olivier-boesch/apico_server/electronics/bees_io/bees_io_pcb_view.png

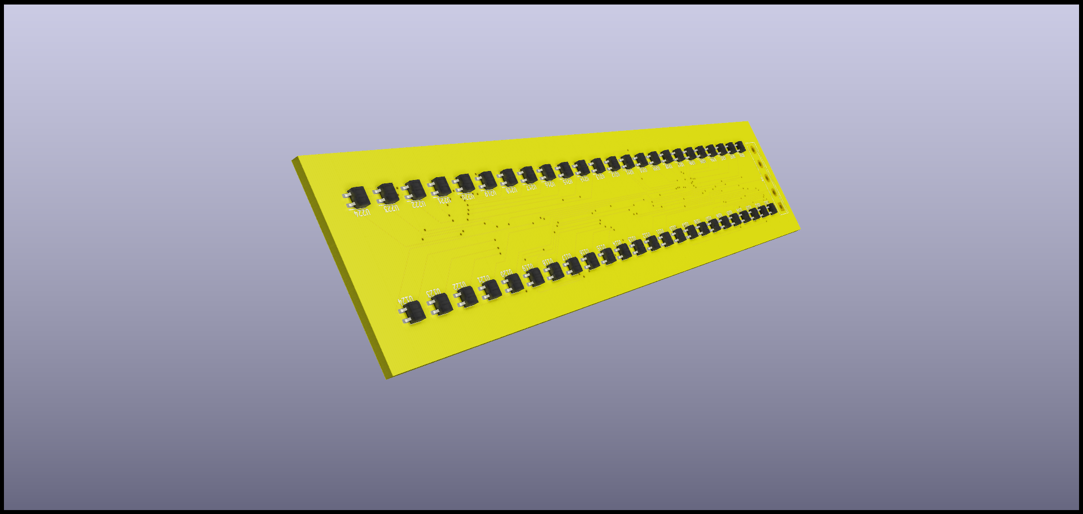
electronics/bees_io/bees_io_pcb_view.png
