olivier-boesch/apico_server/electronics/apico_shield/apico_shield.png

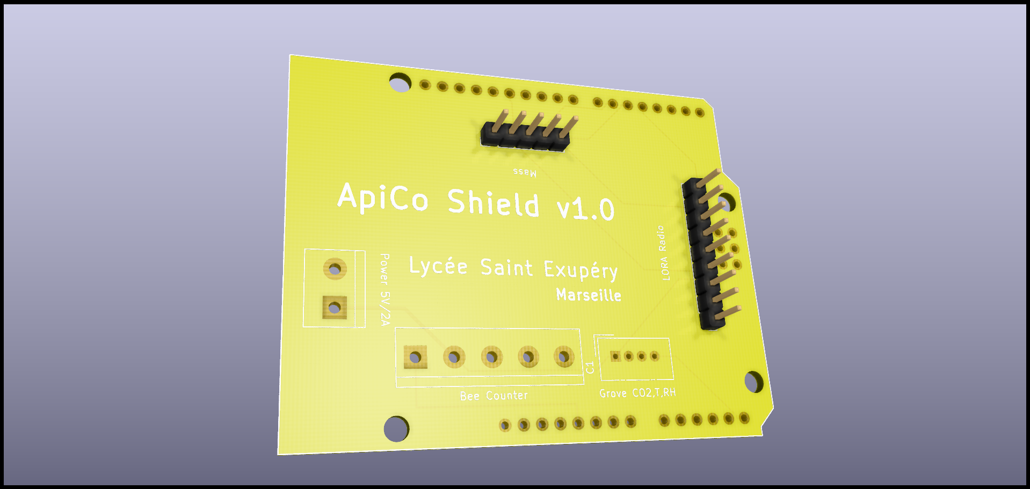
electronics/apico_shield/apico_shield.png
