olivier-boesch/apico_server/3d/apico_arduino_box2.png

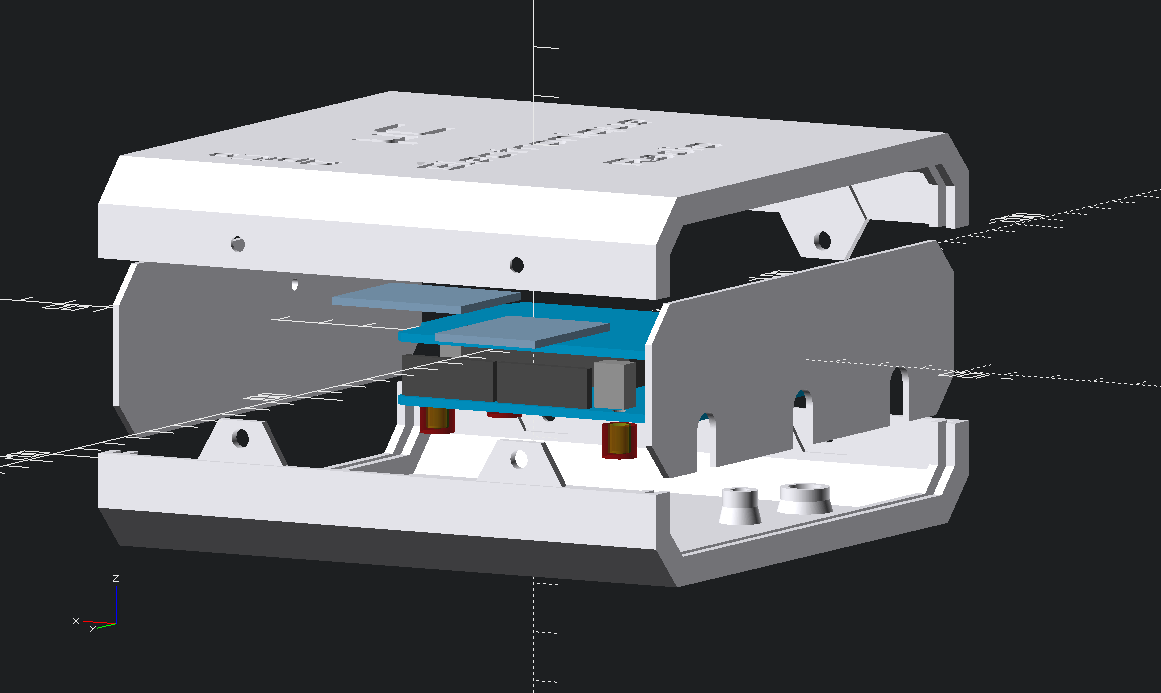
3d/apico_arduino_box2.png
