olivier-boesch/apico_server/3d/apico_arduino_box.png

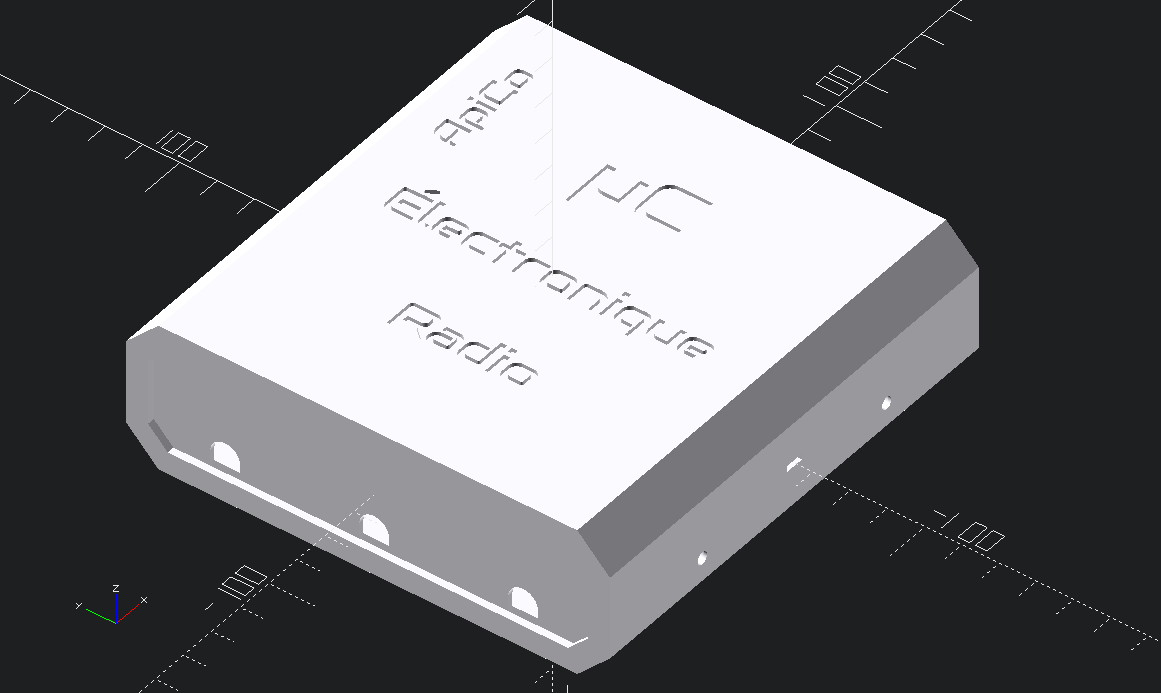
3d/apico_arduino_box.png
