olivier-boesch/apico_server/3d/apico_co2_box2.png

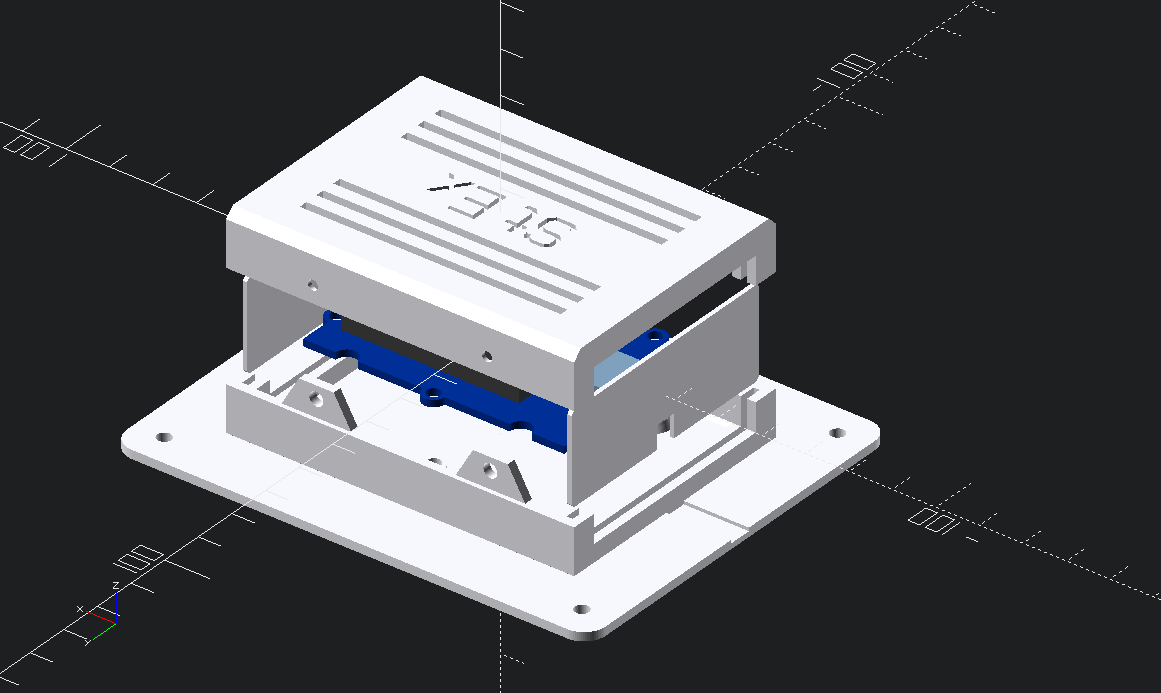
3d/apico_co2_box2.png
