olivier-boesch/apico_server/3d/apico_arduino_box.stl

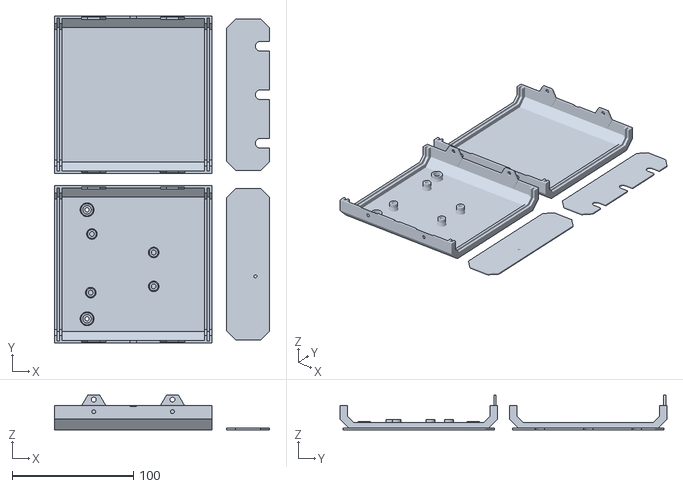
[picture p7: CAD file, 2021-11-12]
3d/apico_arduino_box.stl
177.7 x 270.0 x 28.7
