olivier-boesch/apico_server/3d/apico_co2_box.stl

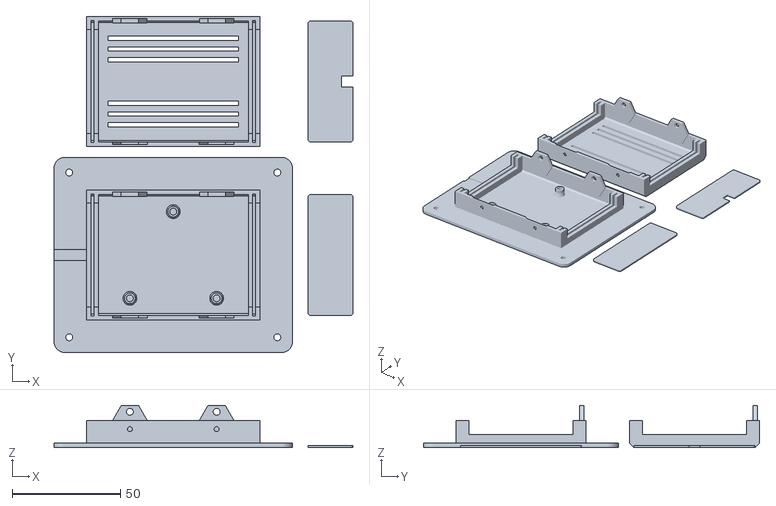
[picture p8: CAD file, 2021-11-12]
3d/apico_co2_box.stl
137.9 x 155.0 x 19.4
