olivier-boesch/apico_server/(list of files, cad)

Other CAD files:
3d/apico_co2_box.scad
