olivier-boesch/apico_server/electronics/bees_io/bees_io_pcb.pdf

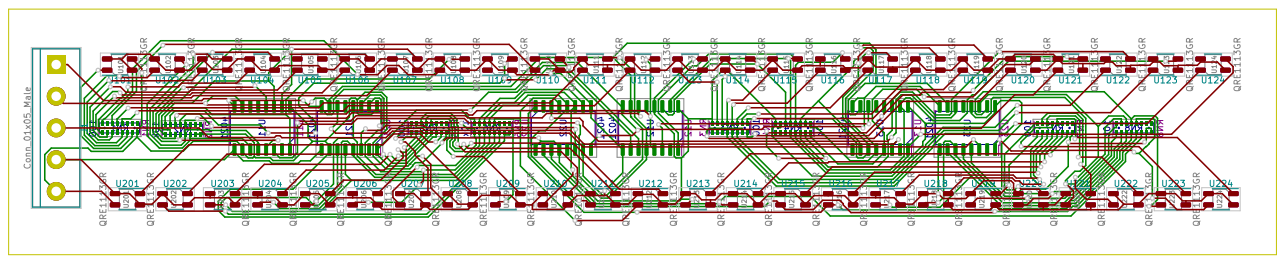
[picture p9: page 1]
