olivier-boesch/apico_server/electronics/bees_io/bees_io_schema.pdf

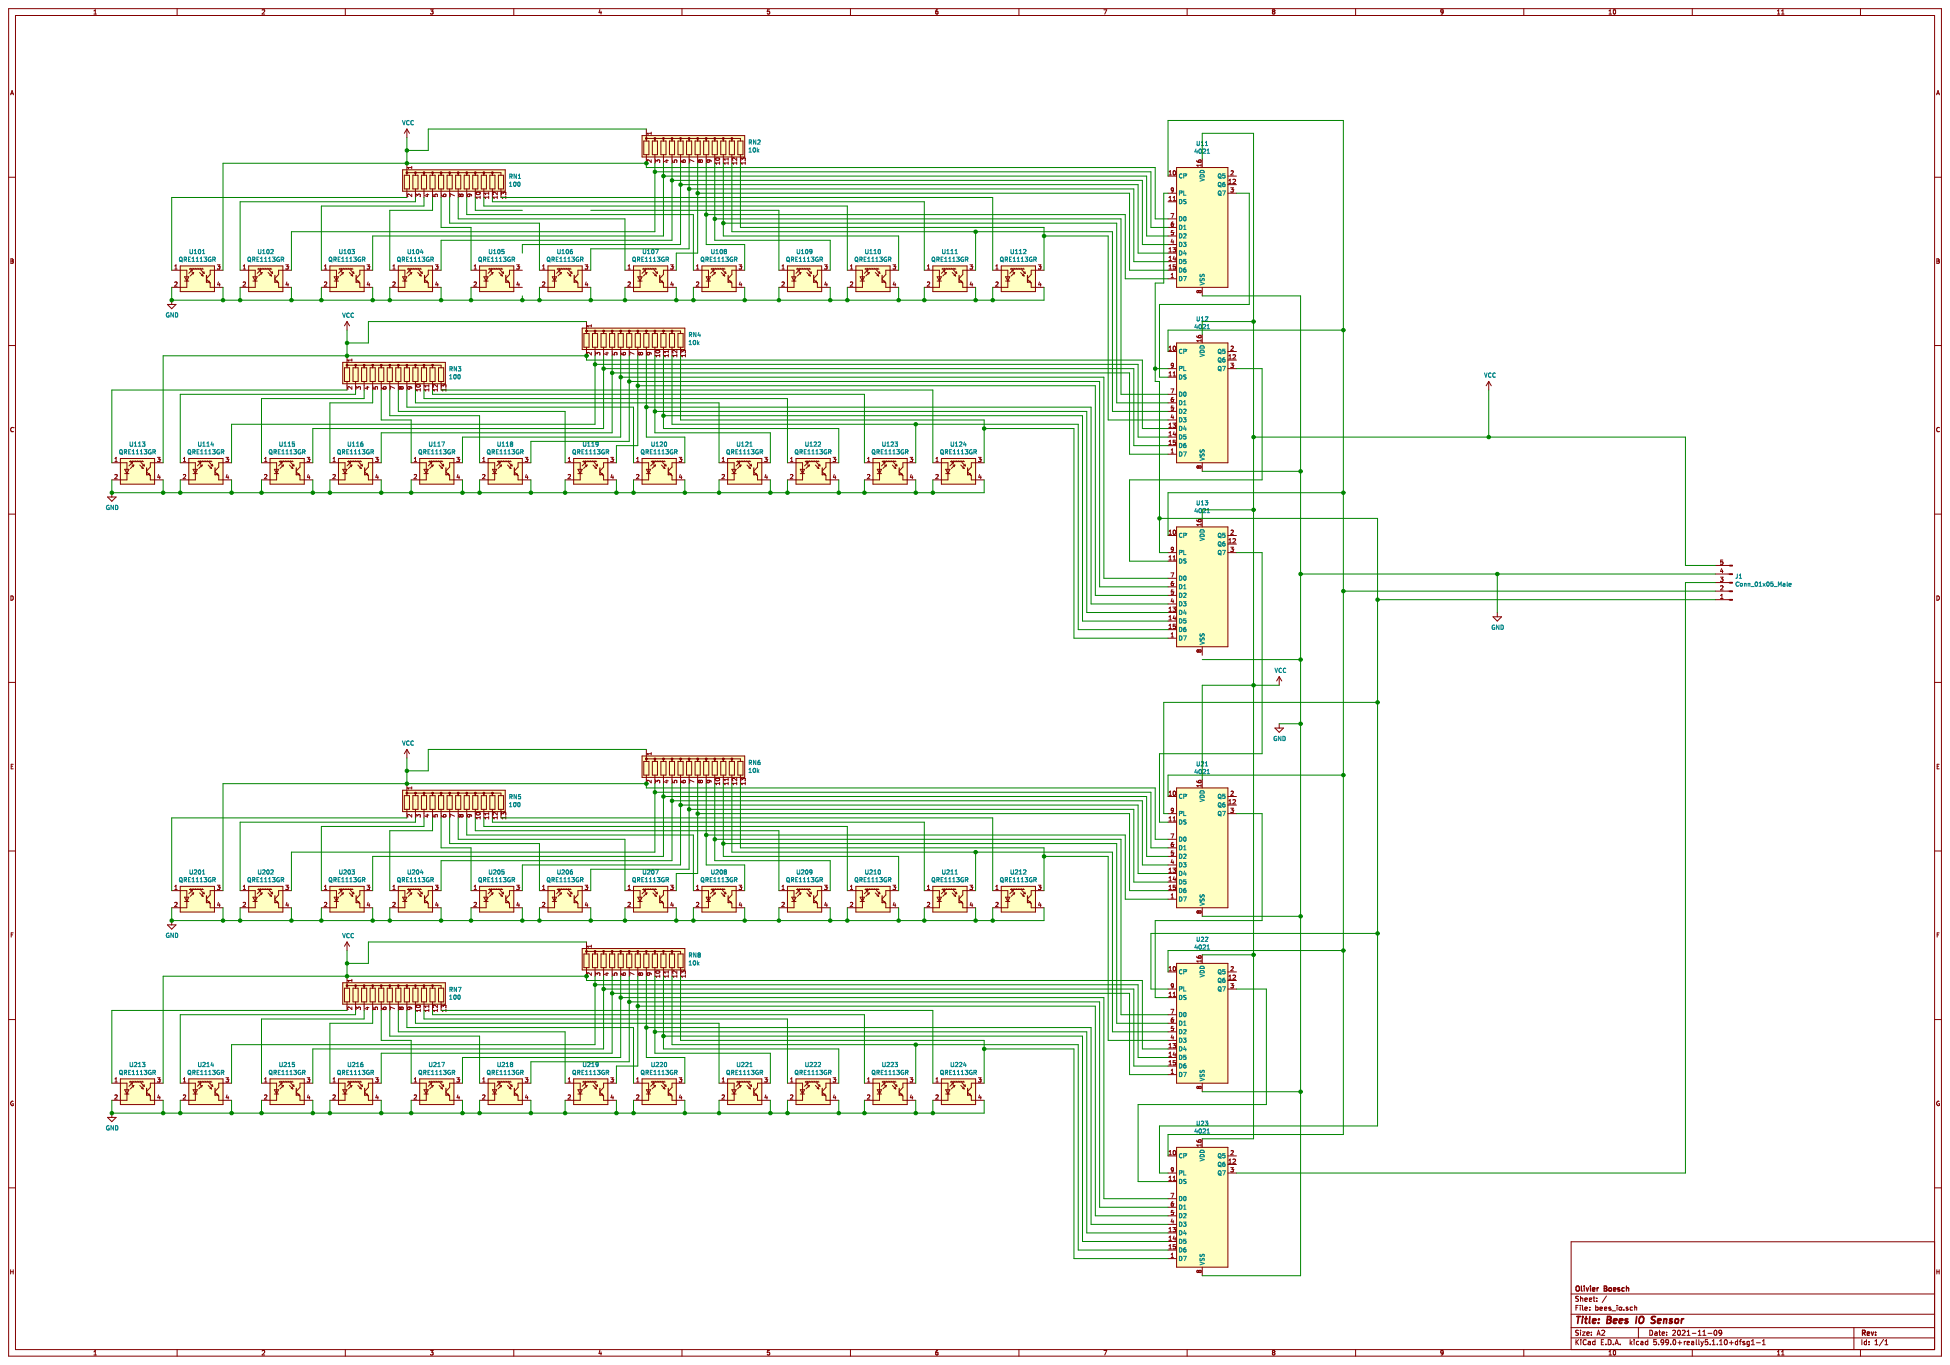
[picture p10: page 1]
