olivier-boesch/apico_server/electronics/apico_shield/schematic.pdf

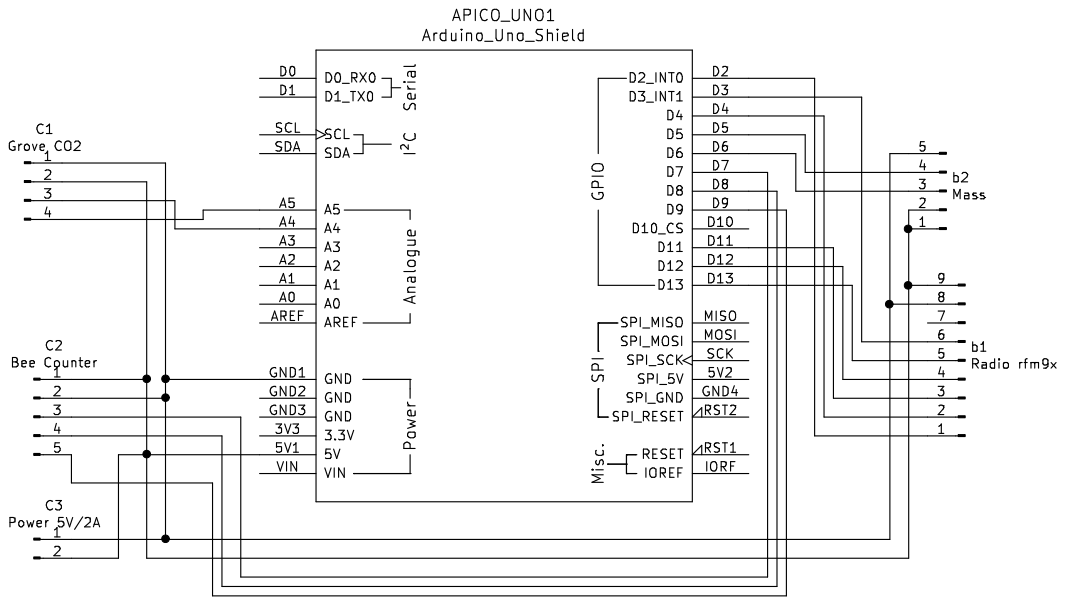
[picture p11: page 1]
