olivier-boesch/apico_server/(list of files, drawings)

Other design files:
electronics/apico_shield/apico_shield.dsn
electronics/bees_io/bees_io.dsn
