olivier-boesch/apico_server/electronics/bees_io/bees_io.kicad_pcb

## KiCad design electronics/bees_io/bees_io.kicad_pcb (2021-11-12)

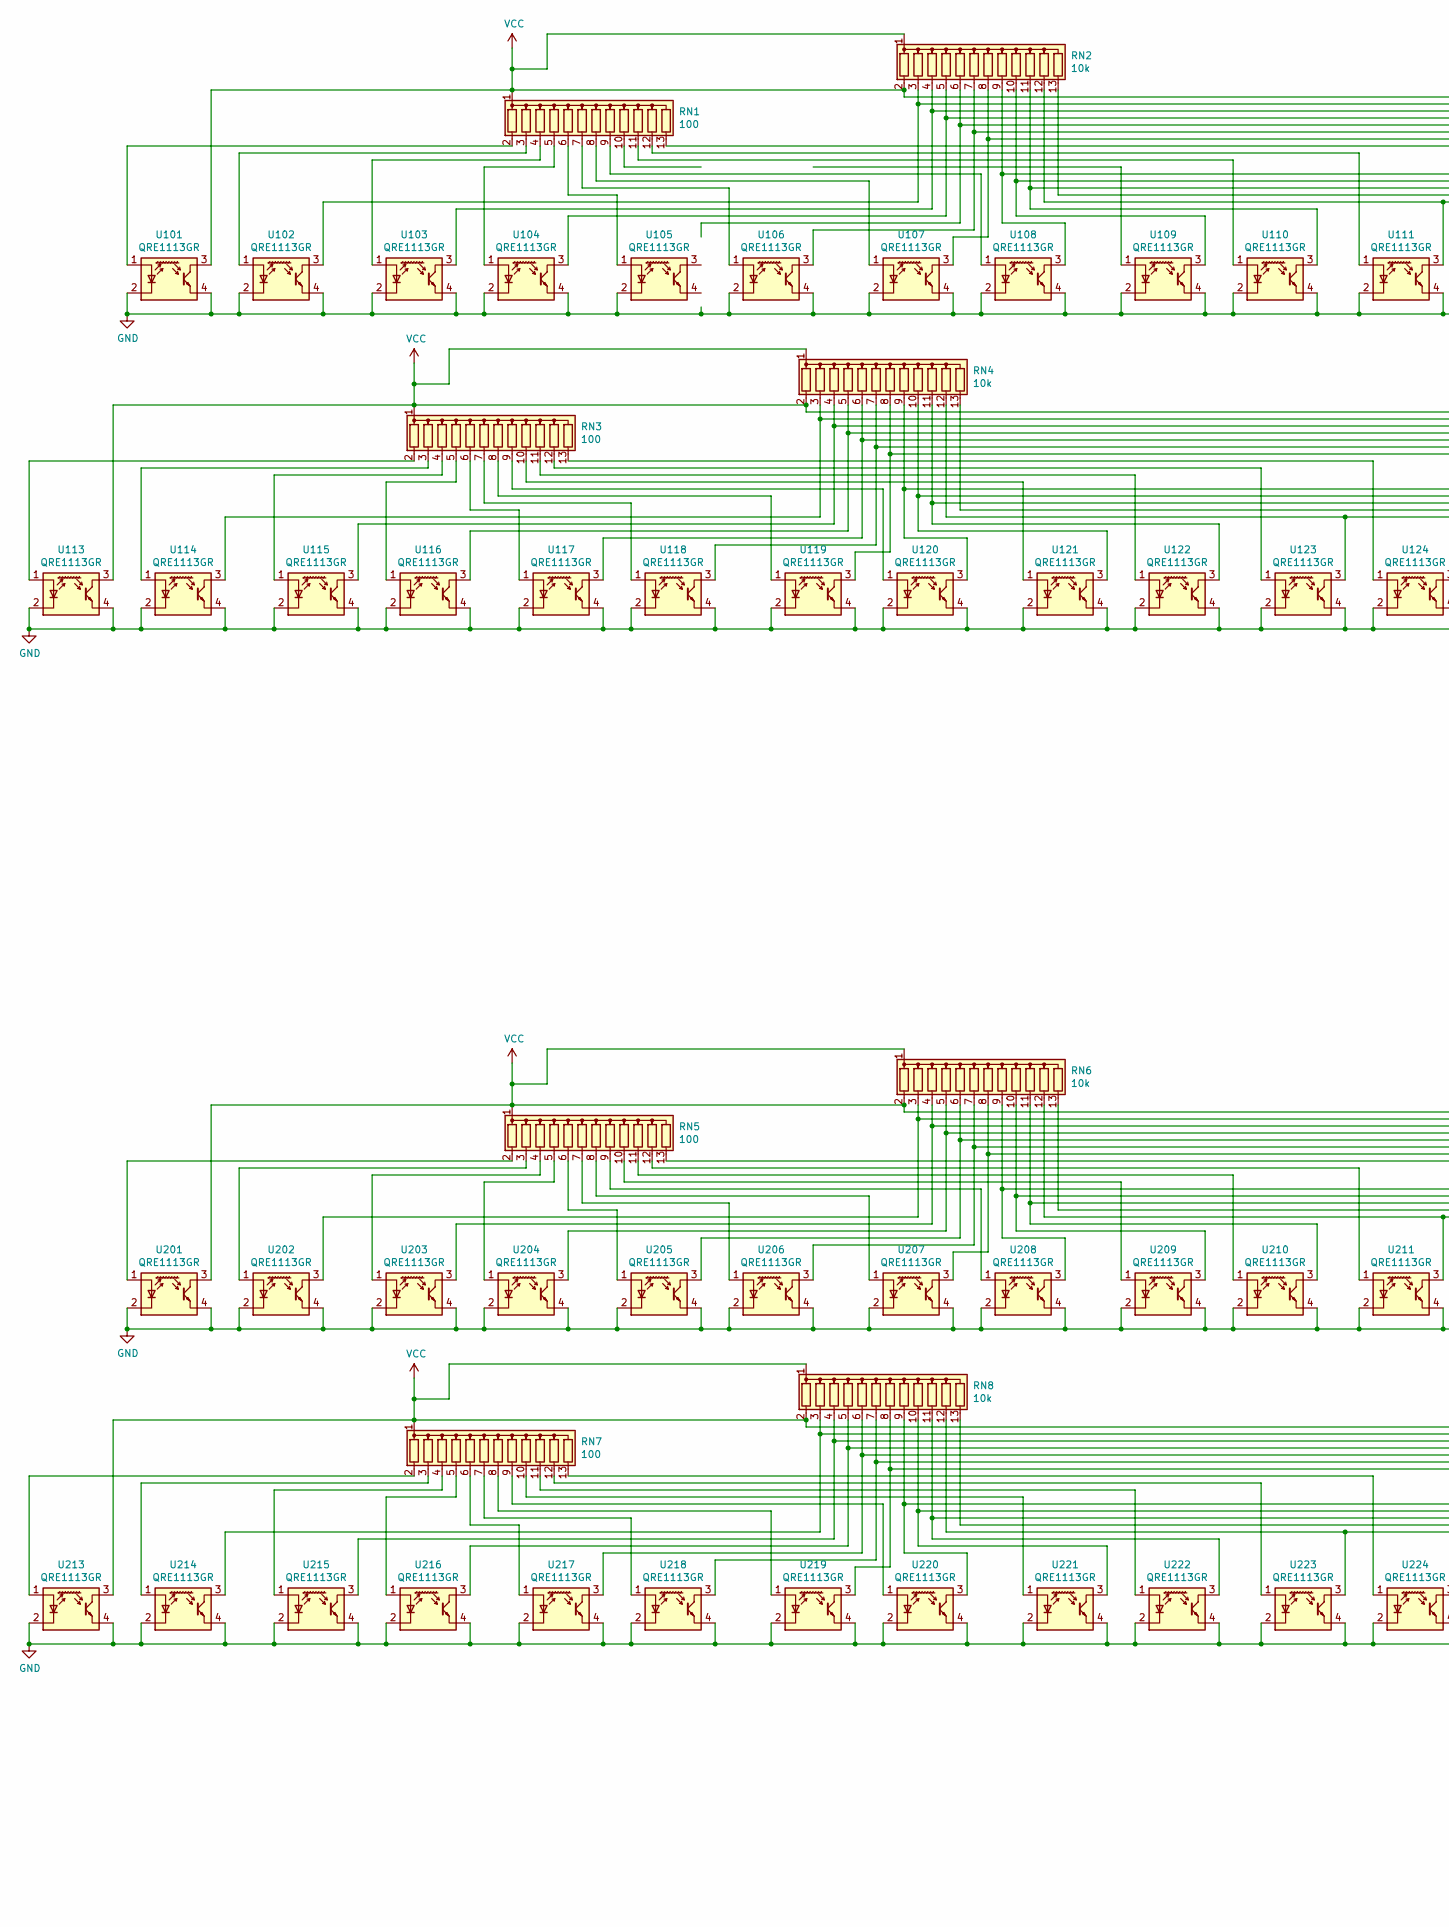
[picture p12: schematic bees_io.sch, Bees IO Sensor, part in row 1, column 1]

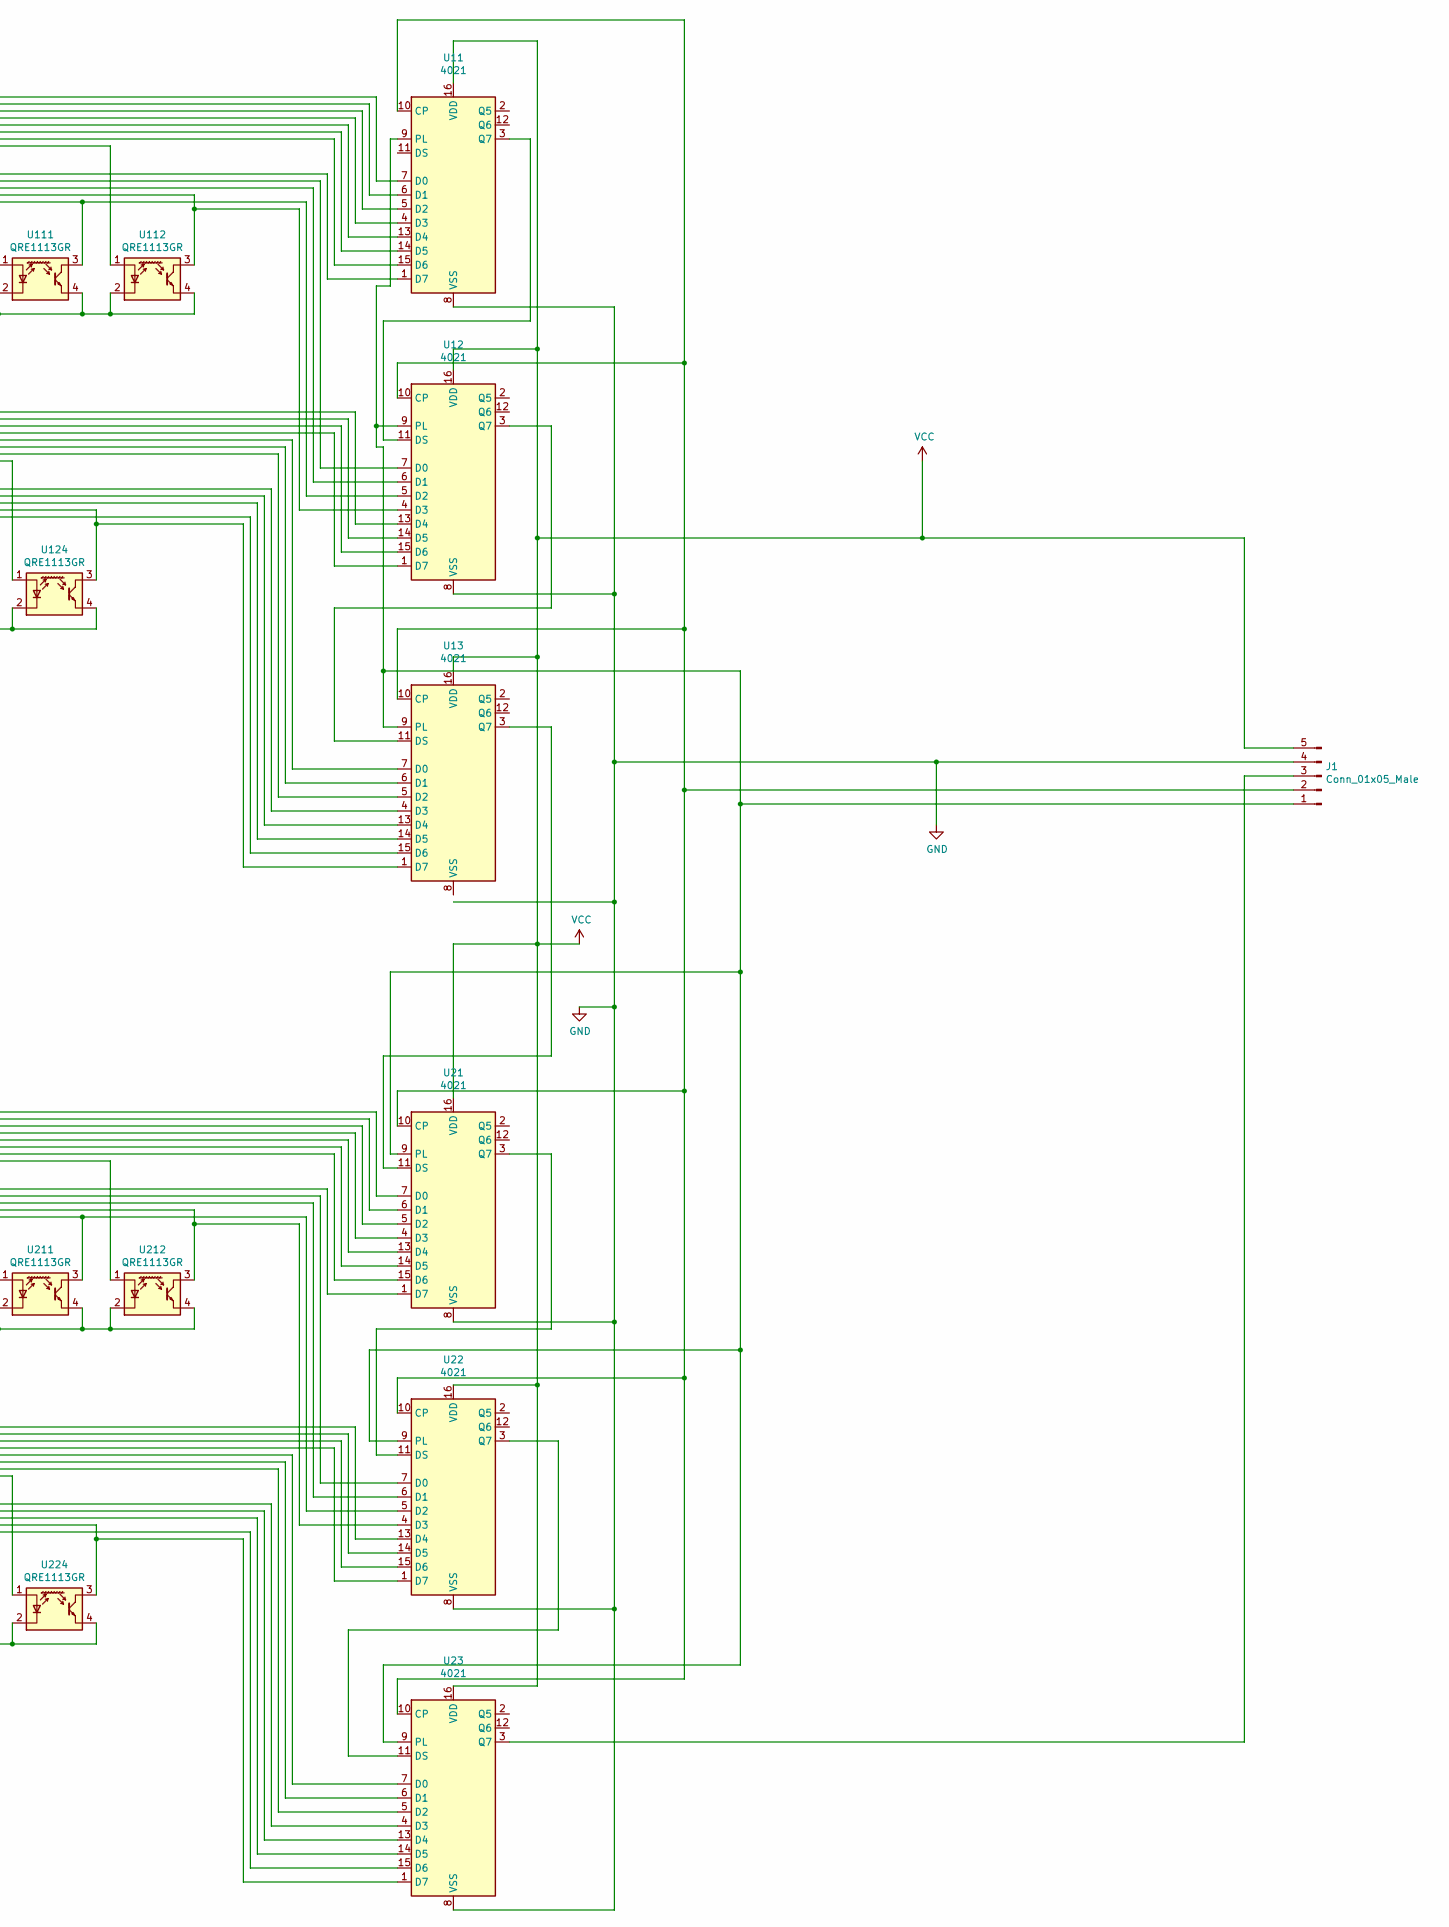
[picture p13: schematic bees_io.sch, Bees IO Sensor, part in row 1, column 2]

Parts:
J1: Conn_01x05_Male; TerminalBlock_bornier-5_P5.08mm
RN1, RN3, RN5, RN7: 100; R_Cat16-8
RN2, RN4, RN6, RN8: 10k; R_Cat16-8
U11, U12, U13, U21, U22, U23: 4021; SO-16_5.3x10.2mm_P1.27mm
U101, U102, U103, U104, U105, U106, U107, U108, U109, U110, U111, U112, U113, U114, U115, U116, U117, U118, U119, U120, U121, U122, U123, U124, U201, U202, U203, U204, U205, U206, U207, U208, U209, U210, U211, U212, U213, U214, U215, U216, U217, U218, U219, U220, U221, U222, U223, U224: QRE1113GR; OnSemi_CASE100CY

Connections:
GND: J1.4, U11.8 (VSS), U12.8 (VSS), U21.8 (VSS), U22.8 (VSS), U23.8 (VSS), U101.2 (K), U101.4, U102.2 (K), U102.4, U103.2 (K), U103.4, U104.2 (K), U104.4, U105.2 (K), U106.2 (K), U106.4, U107.2 (K), U107.4, U108.2 (K), U108.4, U109.2 (K), U109.4, U110.2 (K), U110.4, U111.2 (K), U111.4, U112.2 (K), U112.4, U113.2 (K), U113.4, U114.2 (K), U114.4, U115.2 (K), U115.4, U116.2 (K), U116.4, U117.2 (K), U117.4, U118.2 (K), U118.4, U119.2 (K), U119.4, U120.2 (K), U120.4, U121.2 (K), U121.4, U122.2 (K), U122.4, U123.2 (K), U123.4, U124.2 (K), U124.4, U201.2 (K), U201.4, U202.2 (K), U202.4, U203.2 (K), U203.4, U204.2 (K), U204.4, U205.2 (K), U205.4, U206.2 (K), U206.4, U207.2 (K), U207.4, U208.2 (K), U208.4, U209.2 (K), U209.4, U210.2 (K), U210.4, U211.2 (K), U211.4, U212.2 (K), U212.4, U213.2 (K), U213.4, U214.2 (K), U214.4, U215.2 (K), U215.4, U216.2 (K), U216.4, U217.2 (K), U217.4, U218.2 (K), U218.4, U219.2 (K), U219.4, U220.2 (K), U220.4, U221.2 (K), U221.4, U222.2 (K), U222.4, U223.2 (K), U223.4, U224.2 (K), U224.4
unnamed: J1.1, U11.9 (PL), U12.9 (PL), U13.9 (PL), U21.9 (PL), U22.9 (PL), U23.9 (PL)
unnamed: J1.2, U11.10 (CP), U12.10 (CP), U13.10 (CP), U21.10 (CP), U22.10 (CP), U23.10 (CP)
unnamed: J1.3, U23.3 (Q7)
unnamed: RN1.2 (R1), U101.1 (A)
unnamed: RN1.3 (R2), U102.1 (A)
unnamed: RN1.4 (R3), U103.1 (A)
unnamed: RN1.5 (R4), U104.1 (A)
unnamed: RN1.6 (R5), U105.1 (A)
unnamed: RN1.7 (R6), U106.1 (A)
unnamed: RN1.8 (R7), U107.1 (A)
unnamed: RN1.9 (R8), U108.1 (A)
unnamed: RN1.11 (R10), U110.1 (A)
unnamed: RN1.12 (R11), U111.1 (A)
unnamed: RN1.13 (R12), U112.1 (A)
unnamed: RN2.3 (R2), U11.6 (D1), U102.3
unnamed: RN2.4 (R3), U11.5 (D2), U103.3
unnamed: RN2.5 (R4), U11.4 (D3), U104.3
unnamed: RN2.6 (R5), U11.13 (D4)
unnamed: RN2.7 (R6), U11.14 (D5), U106.3
unnamed: RN2.8 (R7), U11.15 (D6), U107.3
unnamed: RN2.9 (R8), U11.1 (D7), U108.3
unnamed: RN2.10 (R9), U12.7 (D0), U109.3
unnamed: RN2.11 (R10), U12.6 (D1), U110.3
unnamed: RN2.12 (R11), U12.5 (D2), U111.3
unnamed: RN2.13 (R12), U12.4 (D3), U112.3
unnamed: RN3.2 (R1), U113.1 (A)
unnamed: RN3.3 (R2), U114.1 (A)
unnamed: RN3.4 (R3), U115.1 (A)
unnamed: RN3.5 (R4), U116.1 (A)
unnamed: RN3.6 (R5), U117.1 (A)
unnamed: RN3.7 (R6), U118.1 (A)
unnamed: RN3.8 (R7), U119.1 (A)
unnamed: RN3.9 (R8), U120.1 (A)
unnamed: RN3.10 (R9), U121.1 (A)
unnamed: RN3.11 (R10), U122.1 (A)
unnamed: RN3.12 (R11), U123.1 (A)
unnamed: RN3.13 (R12), U124.1 (A)
unnamed: RN4.3 (R2), U12.14 (D5), U114.3
unnamed: RN4.4 (R3), U12.15 (D6), U115.3
unnamed: RN4.5 (R4), U12.1 (D7), U116.3
unnamed: RN4.6 (R5), U13.7 (D0), U117.3
unnamed: RN4.7 (R6), U13.6 (D1), U118.3
unnamed: RN4.8 (R7), U13.5 (D2), U119.3
unnamed: RN4.9 (R8), U13.4 (D3), U120.3
unnamed: RN4.10 (R9), U13.13 (D4), U121.3
unnamed: RN4.11 (R10), U13.14 (D5), U122.3
unnamed: RN4.12 (R11), U13.15 (D6), U123.3
unnamed: RN4.13 (R12), U13.1 (D7), U124.3
unnamed: RN5.2 (R1), U201.1 (A)
unnamed: RN5.3 (R2), U202.1 (A)
unnamed: RN5.4 (R3), U203.1 (A)
unnamed: RN5.5 (R4), U204.1 (A)
unnamed: RN5.6 (R5), U205.1 (A)
unnamed: RN5.7 (R6), U206.1 (A)
unnamed: RN5.8 (R7), U207.1 (A)
unnamed: RN5.9 (R8), U208.1 (A)
unnamed: RN5.10 (R9), U209.1 (A)
unnamed: RN5.11 (R10), U210.1 (A)
unnamed: RN5.12 (R11), U211.1 (A)
unnamed: RN5.13 (R12), U212.1 (A)
unnamed: RN6.3 (R2), U21.6 (D1), U202.3
unnamed: RN6.4 (R3), U21.5 (D2), U203.3
unnamed: RN6.5 (R4), U21.4 (D3), U204.3
unnamed: RN6.6 (R5), U21.13 (D4), U205.3
unnamed: RN6.7 (R6), U21.14 (D5), U206.3
unnamed: RN6.8 (R7), U21.15 (D6), U207.3
unnamed: RN6.9 (R8), U21.1 (D7), U208.3
unnamed: RN6.10 (R9), U22.7 (D0), U209.3
unnamed: RN6.11 (R10), U22.6 (D1), U210.3
unnamed: RN6.12 (R11), U22.5 (D2), U211.3
unnamed: RN6.13 (R12), U22.4 (D3), U212.3
unnamed: RN7.2 (R1), U213.1 (A)
unnamed: RN7.3 (R2), U214.1 (A)
unnamed: RN7.4 (R3), U215.1 (A)
unnamed: RN7.5 (R4), U216.1 (A)
unnamed: RN7.6 (R5), U217.1 (A)
unnamed: RN7.7 (R6), U218.1 (A)
unnamed: RN7.8 (R7), U219.1 (A)
unnamed: RN7.9 (R8), U220.1 (A)
unnamed: RN7.10 (R9), U221.1 (A)
unnamed: RN7.11 (R10), U222.1 (A)
unnamed: RN7.12 (R11), U223.1 (A)
unnamed: RN7.13 (R12), U224.1 (A)
unnamed: RN8.3 (R2), U22.14 (D5), U214.3
unnamed: RN8.4 (R3), U22.15 (D6), U215.3
unnamed: RN8.5 (R4), U22.1 (D7), U216.3
unnamed: RN8.6 (R5), U23.7 (D0), U217.3
unnamed: RN8.7 (R6), U23.6 (D1), U218.3
unnamed: RN8.8 (R7), U23.5 (D2), U219.3
unnamed: RN8.9 (R8), U23.4 (D3), U220.3
unnamed: RN8.10 (R9), U23.13 (D4), U221.3
unnamed: RN8.11 (R10), U23.14 (D5), U222.3
unnamed: RN8.12 (R11), U23.15 (D6), U223.3
unnamed: RN8.13 (R12), U23.1 (D7), U224.3
unnamed: U11.3 (Q7), U12.11 (DS)
unnamed: U12.3 (Q7), U13.11 (DS)
unnamed: U13.3 (Q7), U21.11 (DS)
unnamed: U21.3 (Q7), U22.11 (DS)
unnamed: U22.3 (Q7), U23.11 (DS)
VCC: J1.5, RN1.1 (common), RN2.1 (common), RN2.2 (R1), RN3.1 (common), RN4.1 (common), RN4.2 (R1), RN5.1 (common), RN6.1 (common), RN6.2 (R1), RN7.1 (common), RN8.1 (common), RN8.2 (R1), U11.7 (D0), U11.16 (VDD), U12.13 (D4), U12.16 (VDD), U13.16 (VDD), U21.7 (D0), U21.16 (VDD), U22.13 (D4), U22.16 (VDD), U23.16 (VDD), U101.3, U113.3, U201.3, U213.3

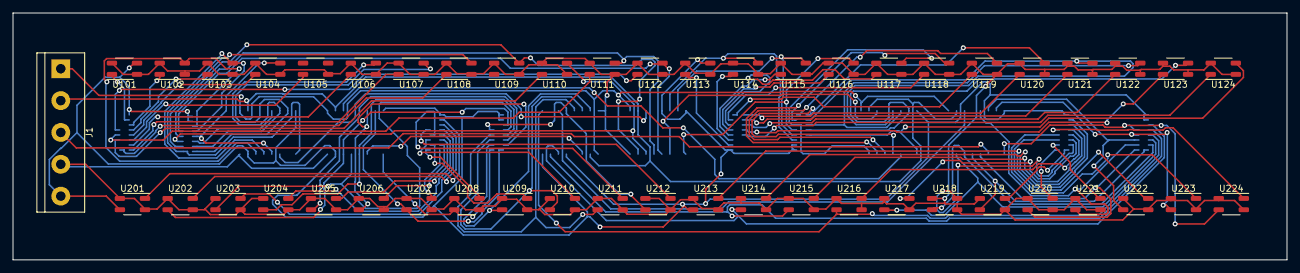
[picture p14: board bees_io.kicad_pcb from above]

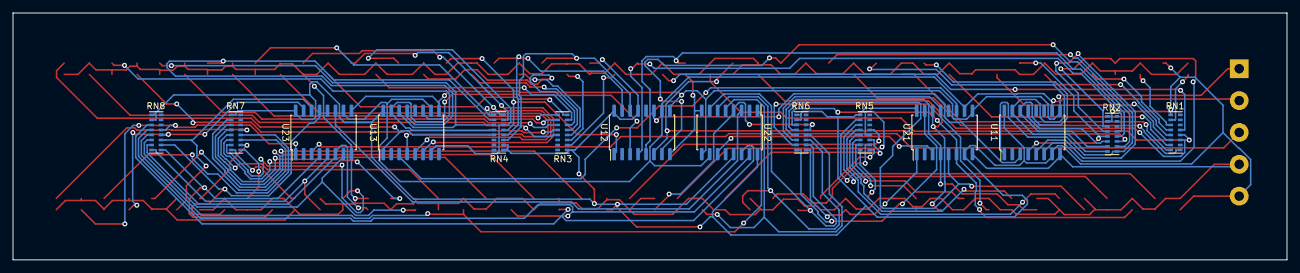
[picture p15: board bees_io.kicad_pcb from below]

Board: 2 copper layers, 203.2 x 39.4 mm, 63 parts (14 on the bottom side), 101 nets.
