olivier-boesch/apico_server/electronics/apico_shield/apico_shield.kicad_pcb

## KiCad design electronics/apico_shield/apico_shield.kicad_pcb (2021-11-06)

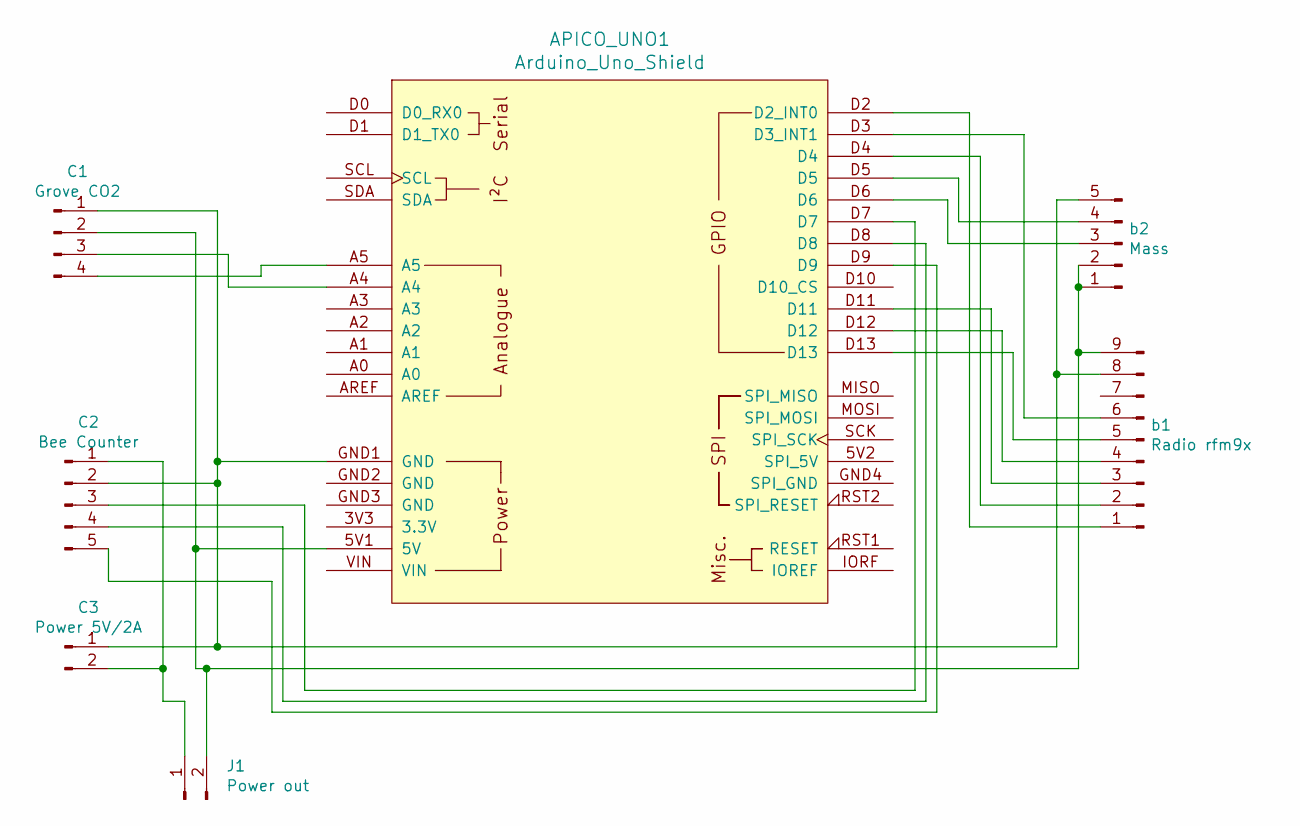
[picture p16: schematic apico_shield.sch, Apico Shield]

Parts:
APICO_UNO1: Arduino_Uno_Shield
C1: Grove CO2; NS-Tech_Grove_1x04_P2mm_Vertical
C2: Bee Counter; TerminalBlock_bornier-5_P5.08mm
C3: Power 5V/2A; TerminalBlock_bornier-2_P5.08mm
J1: Power out; PinHeader_1x02_P2.54mm_Vertical
b1: Radio rfm9x; PinHeader_1x09_P2.54mm_Vertical
b2: Mass; PinHeader_1x05_P2.54mm_Vertical

Connections:
unnamed: APICO_UNO1.5V1 (5V), C1.2, J1.2, b1.9, b2.1, b2.2
unnamed: APICO_UNO1.A4, C1.3
unnamed: APICO_UNO1.A5, C1.4
unnamed: APICO_UNO1.D2 (D2_INT0), b1.1
unnamed: APICO_UNO1.D3 (D3_INT1), b1.6
unnamed: APICO_UNO1.D4, b1.2
unnamed: APICO_UNO1.D5, b2.4
unnamed: APICO_UNO1.D6, b2.3
unnamed: APICO_UNO1.D7, C2.3
unnamed: APICO_UNO1.D8, C2.4
unnamed: APICO_UNO1.D9, C2.5
unnamed: APICO_UNO1.D11, b1.3
unnamed: APICO_UNO1.D12, b1.4
unnamed: APICO_UNO1.D13, b1.5
unnamed: APICO_UNO1.GND1 (GND), C1.1, C2.2, C3.1, b1.8, b2.5
unnamed: C2.1, C3.2, J1.1

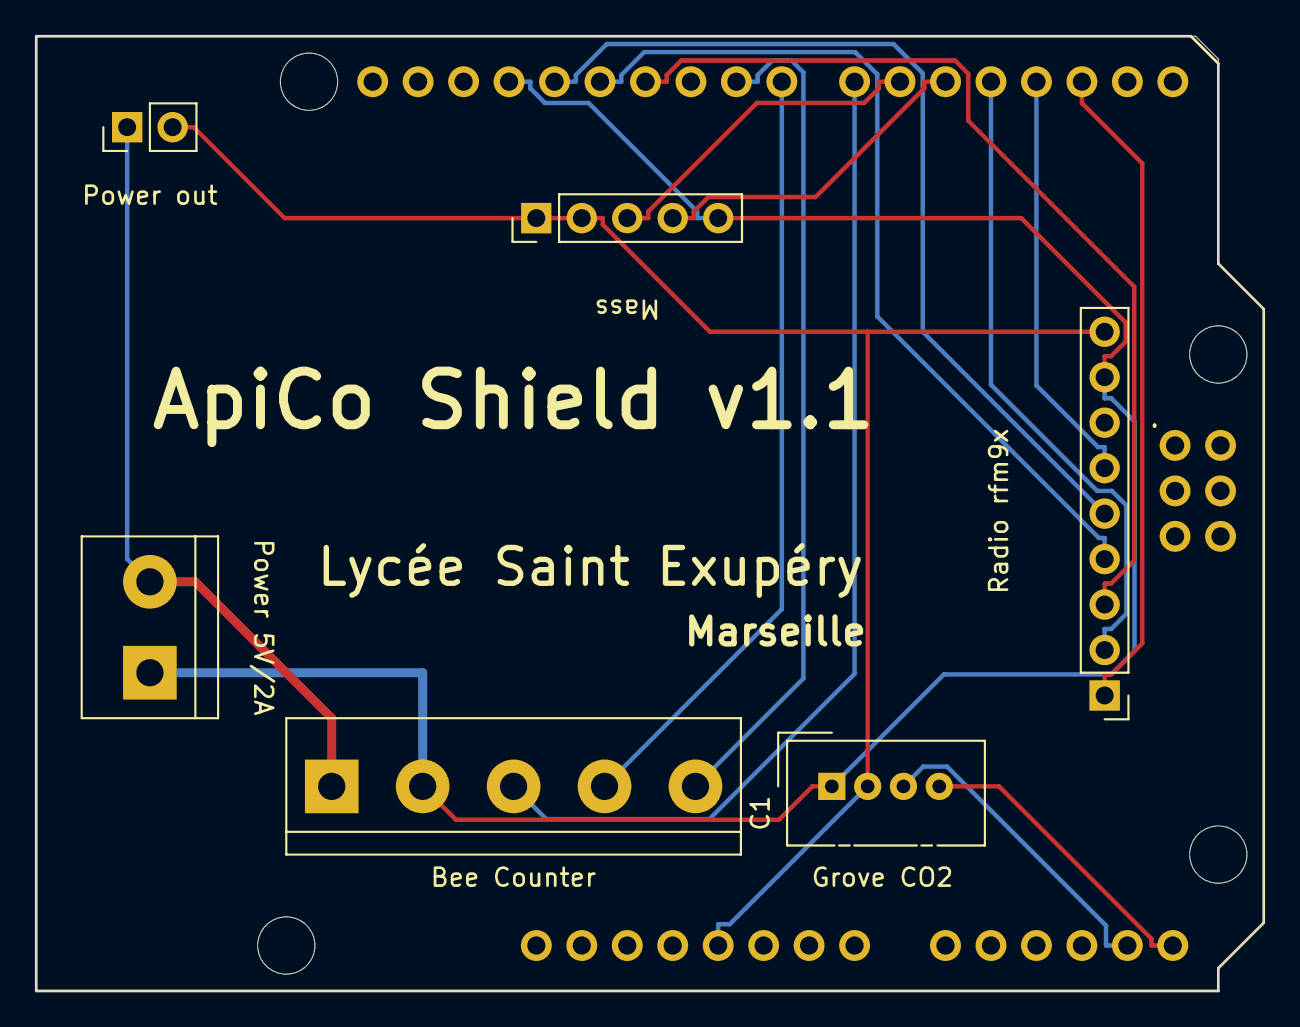
[picture p17: board apico_shield.kicad_pcb from above]

Board: 2 copper layers, 68.6 x 53.3 mm, 7 parts (0 on the bottom side), 16 nets.
