olivier-boesch/apico_server/settings.py

DB_HOST = "localhost"
DB_USER = "apico"
DB_PASS = "apico2021_larmande"
DB_DB = "ApiCo"
DB_CHARSET = "utf8"  # ???

DISPLAY_HOST = "localhost"
DISPLAY_PORT = 9000
DISPLAT_ADDRESS = (DISPLAY_HOST, DISPLAY_PORT)

HIVES_NUMBER = 5
