olivier-boesch/apico_server/(commit log)

2021-11-06 updated pcb
    [apico_shield.dsn, apico_shield.kicad_pcb, apico_shield.sch]
2021-11-07 added 3d files
    [apico_arduino_box.scad, apico_arduino_box.stl, apico_co2_box.scad, apico_co2_box.stl]
2021-11-12 minor changes
    [apico_arduino_box.scad, apico_arduino_box.stl, apico_co2_box.scad, apico_co2_box.stl]
2021-11-12 added lora logo
    [bees_io.kicad_pcb]
2021-11-12 modified electronics
    [bees_io.dsn, bees_io.sch]
